rafaelbidese/rfid-telemetry/node/README.md

# Sensor Node

<p align="center">
  
</p>

- **LM35:** Temperature sensor
- **Arduino Nano:** microcontrolling unit
- **FS1000A:** 433MHz radio transmitter
- **Firmware:** RadioHead ASK lib

## Wiring

**Arduino Nano -> Battery**

Vin -> 9V

**Arduino Nano -> FS1000A**

~11 -> ATAD

VIN -> VCC

GND -> GND
