rafaelbidese/rfid-telemetry/(commit log)

2018-02-19 Added some changes and pictures of the prototypes
2018-02-19 Add wiring schematics for the hardware
